GeoffroyLoiselet/Projet_2a_Drone_Amphibie/README.md

# Projet_2a_Drone_Amphibie
Projet drone amphibie ENSEA 2ème année
