GeoffroyLoiselet/Projet_2a_Drone_Amphibie/les étapes pour programmer le joystick.docx

Les étapes à suivre pour programmer le joystick :

SYS-→ Debug --→ Serial Wire

RCC -→ High speed clock (HSE) -→ Crystal ceramic resonator.

Analog → ADC1 Mode : – IN1→ Single Ended

-IN2 → Single Ended

Parameter Settings : Continuous Conversion Mode : Enable

Number of conversion : 2

Rank 1 → channel 1

Sampling time 640 cycles

Rank 2 -→ channel 2

Sampling time 640 cycles

DMA settings -→ add

Clique sur adc1puis choisis le mode circular

Data width : word dans les deux peripheral et memory

DMA Continuous Requests -→ Enabled

System view --→ NVIC -→ cochez ADC1 interrupt

Choisis un GPIO pour le bouton (exemple PA8) et mets le en GPIO-input

Allez au GPIO et mets le pin en Pull-up

Connectivity :

USART2 → Mode : Asynchronous

Génère le code Ctrl + S

Le code : (les parties importantes)

#include "main.h"

#include "stdio.h"

#include "string.h"

ADC_HandleTypeDef hadc1;

DMA_HandleTypeDef hdma_adc1;

UART_HandleTypeDef huart2;

uint16_t xValue;

uint16_t yValue;

uint32_t readValue [2];

uint8_t button_state;

char buffer[50];

void SystemClock_Config(void);

static void MX_GPIO_Init(void);

static void MX_DMA_Init(void);

static void MX_ADC1_Init(void);

static void MX_USART2_UART_Init(void);

int main(void)

{

HAL_Init();

SystemClock_Config();

MX_GPIO_Init();

MX_DMA_Init();

MX_ADC1_Init();

MX_USART2_UART_Init();

/* USER CODE BEGIN 2 */

HAL_ADC_Start_DMA(&hadc1, (uint32_t*)readValue, 2);

while (1)

{

/* USER CODE END WHILE */

for (uint8_t i =0 ;i<hadc1.Init.NbrOfConversion;i++){

xValue = (uint16_t ) readValue[0];

yValue = (uint16_t ) readValue[1];

}

button_state=HAL_GPIO_ReadPin(GPIOA, GPIO_PIN_8);

snprintf(buffer,sizeof(buffer),"Xvalue : %d, Yvalue : %d, Button : %d \r\n",xValue,yValue,button_state);

HAL_UART_Transmit(&huart2, (uint8_t *) buffer , sizeof(buffer), HAL_MAX_DELAY);

HAL_Delay(300);

/* USER CODE BEGIN 3 */

}

/* USER CODE END 3 */

}

Un video pour comprendre : https://youtu.be/rQGIqen2qxA
