GeoffroyLoiselet/Projet_2a_Drone_Amphibie/Manette/NRF24_protocole.txt

Warning pour l'utilisation du nrf24l01:

mettre un 1 a la 5e position du registre a laquelle tu veux adresser.
