GeoffroyLoiselet/Projet_2a_Drone_Amphibie/Drone/comprendre/Yaw_Axis_Corrected.svg.png

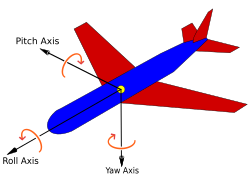
Drone/comprendre/Yaw_Axis_Corrected.svg.png
