GeoffroyLoiselet/Projet_2a_Drone_Amphibie/final.stp

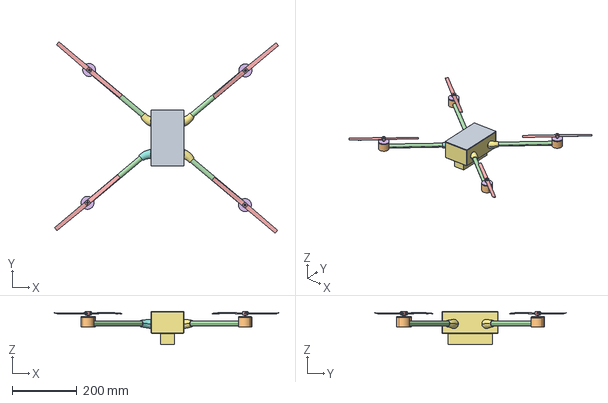
[picture p21: CAD file, 2025-11-04]
final.stp
689.7 x 589.5 x 103.0 mm
