GeoffroyLoiselet/Projet_2a_Drone_Amphibie/Model/Drone_projet v7.step

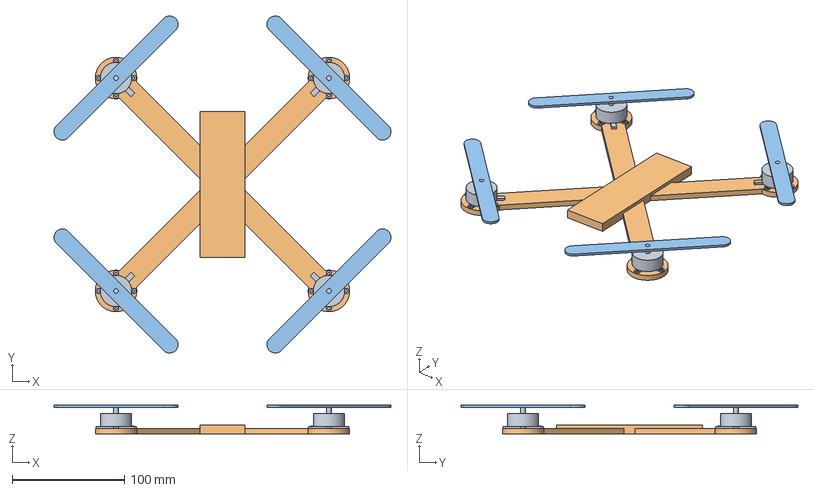
[picture p22: CAD file, 2025-10-07]
Model/Drone_projet v7.step
299.9 x 299.9 x 25.6 mm
moteur_projet x 4
Chassis_projet
Helice x 4
