GeoffroyLoiselet/Projet_2a_Drone_Amphibie/Model/Chassis_projet v4.step

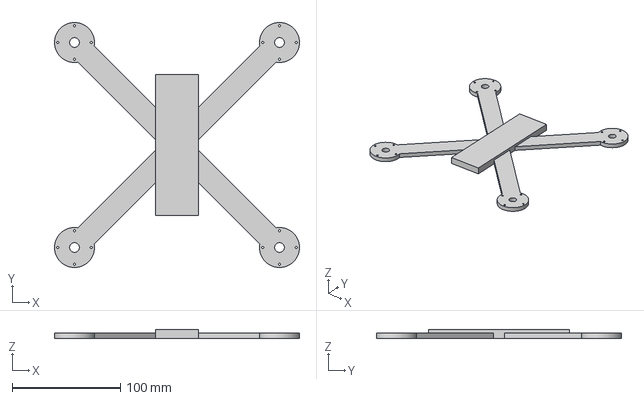
[picture p23: CAD file, 2025-10-07]
Model/Chassis_projet v4.step
226.5 x 226.5 x 8.00 mm
