GeoffroyLoiselet/Projet_2a_Drone_Amphibie/Model/Helice v5.step

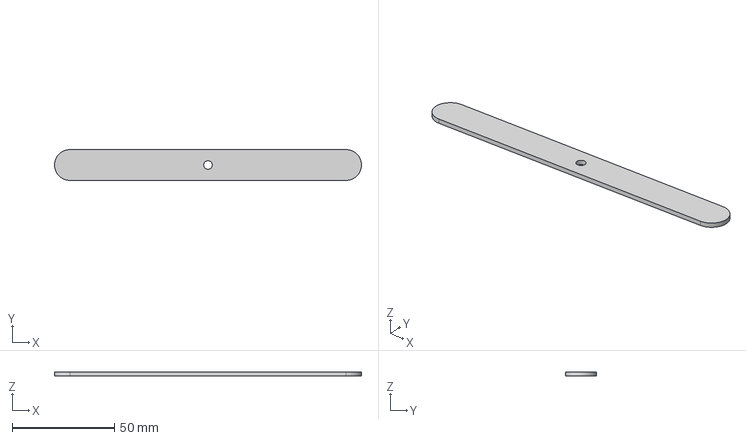
[picture p24: CAD file, 2025-10-07]
Model/Helice v5.step
150.0 x 15.0 x 2.00 mm
