GeoffroyLoiselet/Projet_2a_Drone_Amphibie/Model/moteur_projet v5.step

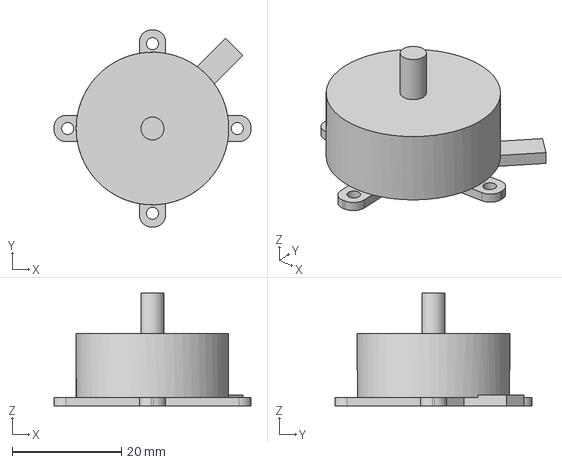
[picture p25: CAD file, 2025-10-07]
Model/moteur_projet v5.step
36.0 x 36.0 x 20.6 mm
