GeoffroyLoiselet/Projet_2a_Drone_Amphibie/Drone/PCB/V2/Puissance/Puissance.kicad_pcb

## KiCad design Drone/PCB/V2/Puissance/Puissance.kicad_pcb (2026-02-17)

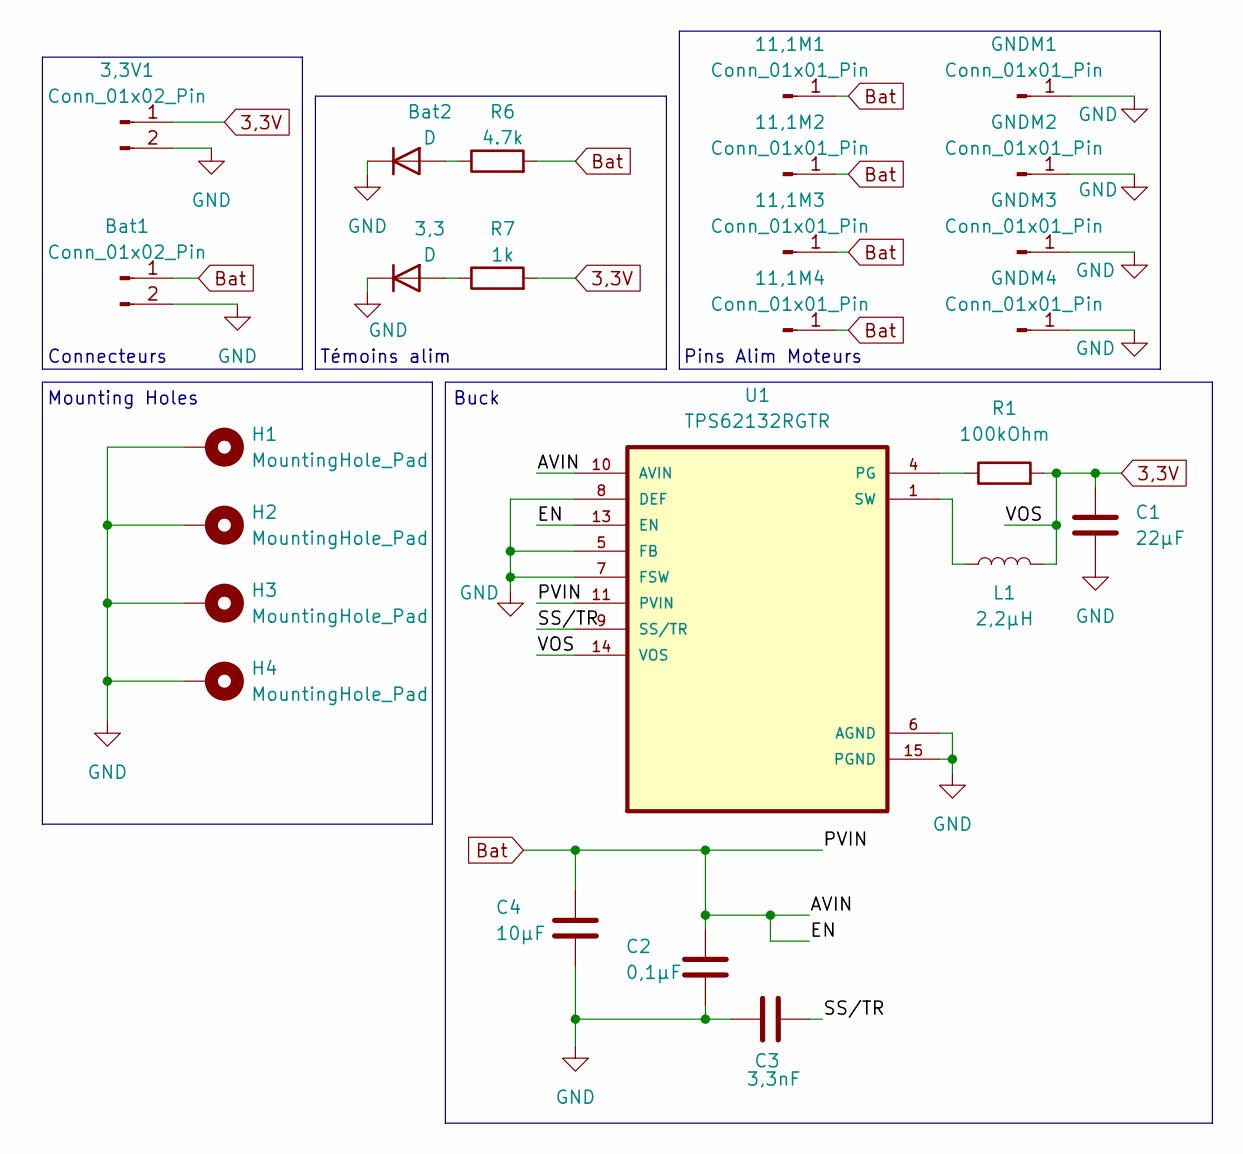
[picture p26: schematic Puissance.kicad_sch]

Parts:
3,3: D; D_0603_1608Metric_Pad1.05x0.95mm_HandSolder
3,3V1: Conn_01x02_Pin; PinSocket_1x02_P2.54mm_Vertical
11,1M1, 11,1M2, 11,1M3, 11,1M4: Conn_01x01_Pin; SolderWire-1.5sqmm_1x01_D1.7mm_OD3mm
Bat1: Conn_01x02_Pin; SolderWire-1.5sqmm_1x02_P6mm_D1.7mm_OD3mm
Bat2: D; D_0603_1608Metric_Pad1.05x0.95mm_HandSolder
C1: 22µF; C_0603_1608Metric_Pad1.08x0.95mm_HandSolder
C2: 0,1µF; C_0603_1608Metric_Pad1.08x0.95mm_HandSolder
C3: 3,3nF; C_0603_1608Metric_Pad1.08x0.95mm_HandSolder
C4: 10µF; C_0603_1608Metric_Pad1.08x0.95mm_HandSolder
GNDM1, GNDM2, GNDM3, GNDM4: Conn_01x01_Pin; SolderWire-1.5sqmm_1x01_D1.7mm_OD3mm
H1, H2, H3, H4: MountingHole_Pad; MountingHole_3.2mm_M3_DIN965_Pad
L1: 2,2µH; L_0603_1608Metric_Pad1.05x0.95mm_HandSolder
R1: 100kOhm; R_0201_0603Metric_Pad0.64x0.40mm_HandSolder
R6: 4.7k; R_0603_1608Metric_Pad0.98x0.95mm_HandSolder
R7: 1k; R_0603_1608Metric_Pad0.98x0.95mm_HandSolder
U1: TPS62132RGTR; VQFN-16-1EP_3x3mm_P0.5mm_EP1.1x1.1mm_ThermalVias

Connections:
3,3V: 3,3V1.1, C1.1, L1.2, R1.2, R7.2, U1.14 (VOS)
/SS/TR: C3.2, U1.9 (SS/TR)
Bat: 11,1M1.1, 11,1M2.1, 11,1M3.1, 11,1M4.1, Bat1.1, C2.1, C4.1, R6.2, U1.10 (AVIN), U1.11 (PVIN), U1.12 (PVIN), U1.13 (EN)
GND: 3,3.1 (K), 3,3V1.2, Bat1.2, Bat2.1 (K), C1.2, C2.2, C3.1, C4.2, GNDM1.1, GNDM2.1, GNDM3.1, GNDM4.1, H1.1, H2.1, H3.1, H4.1, U1.5 (FB), U1.6 (AGND), U1.7 (FSW), U1.8 (DEF), U1.15 (PGND), U1.16 (PGND), U1.17 (PGND)
unnamed: 3,3.2 (A), R7.1
unnamed: Bat2.2 (A), R6.1
unnamed: L1.1, U1.1 (SW), U1.2 (SW), U1.3 (SW)
unnamed: R1.1, U1.4 (PG)

Notes on the sheet:
Pins Alim Moteurs
Connecteurs
Buck
Mounting Holes
Témoins alim

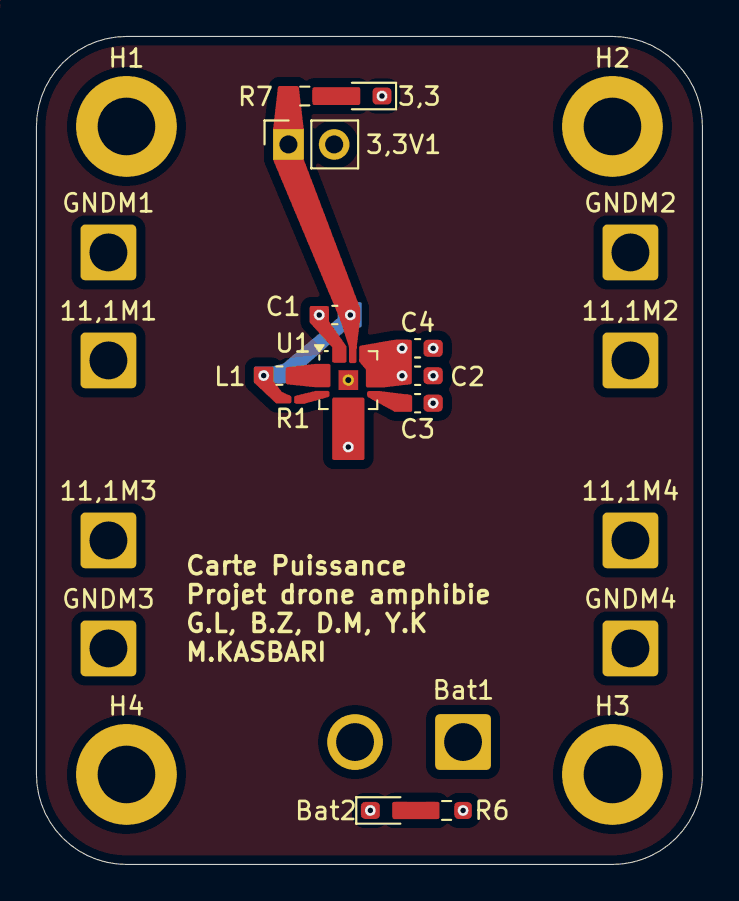
[picture p27: board Drone/PCB/V2/Puissance/Puissance.kicad_pcb from above]

Board: 4 copper layers, 37.0 x 46.0 mm, 25 parts (0 on the bottom side), 8 nets.
