GeoffroyLoiselet/Projet_2a_Drone_Amphibie/Drone/PCB/V2/Drone/Drone.kicad_pcb

## KiCad design Drone/PCB/V2/Drone/Drone.kicad_pcb (2026-02-17)

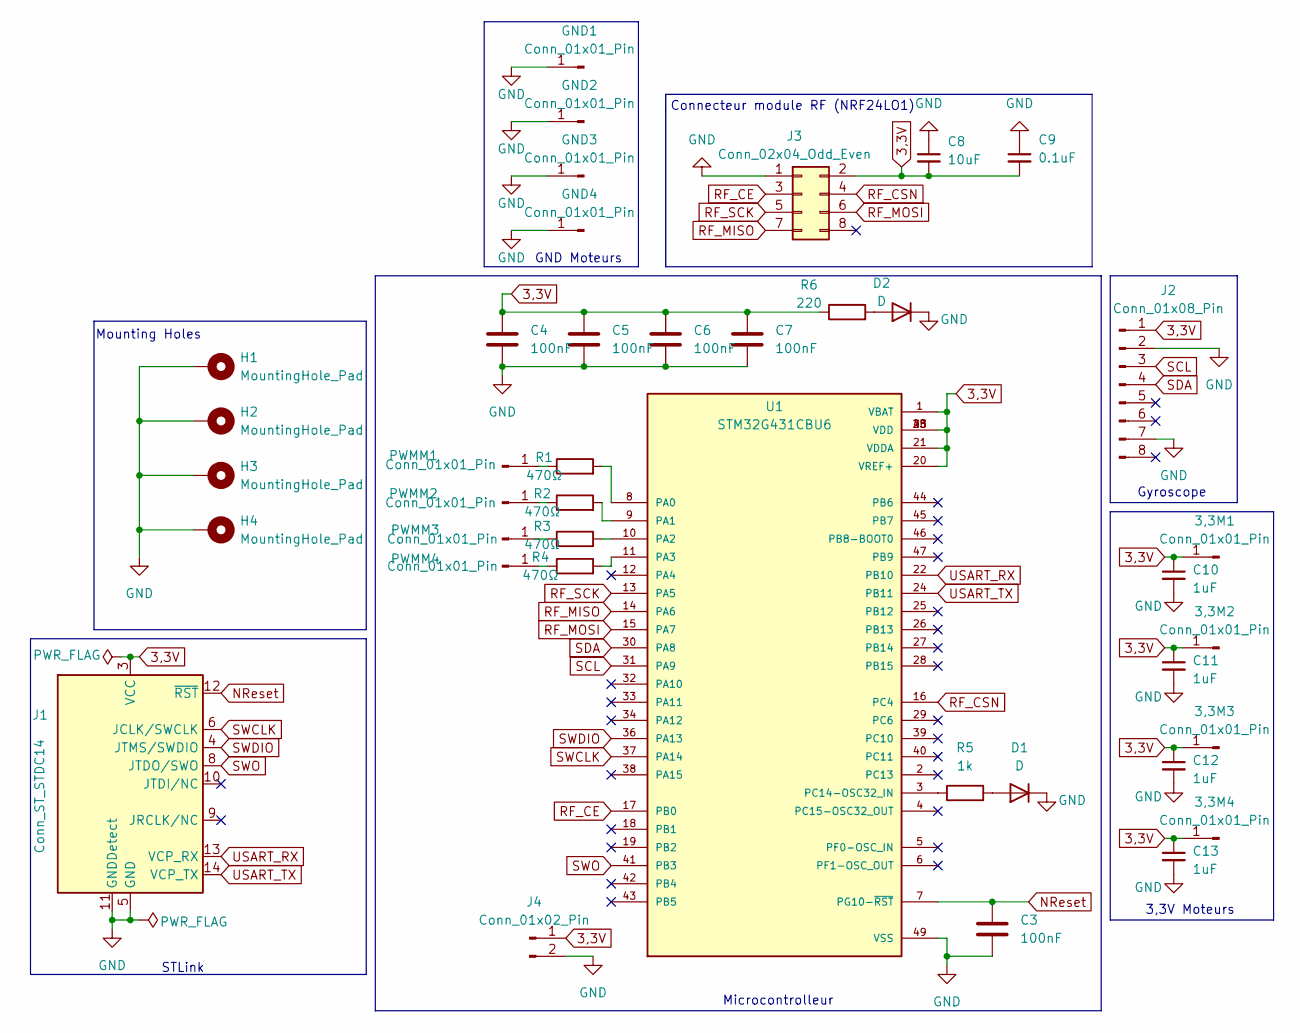
[picture p28: schematic Drone.kicad_sch, PCB_Drone]

Parts:
3,3M1, 3,3M2, 3,3M3, 3,3M4: Conn_01x01_Pin; SolderWire-0.75sqmm_1x01_D1.25mm_OD2.3mm
C3, C4, C5, C6, C7: 100nF; C_0603_1608Metric_Pad1.08x0.95mm_HandSolder
C8: 10uF; C_0603_1608Metric_Pad1.08x0.95mm_HandSolder
C9: 0.1uF; C_0603_1608Metric_Pad1.08x0.95mm_HandSolder
C10, C11, C12, C13: 1uF; C_0603_1608Metric_Pad1.08x0.95mm_HandSolder
D1, D2: D; D_0603_1608Metric_Pad1.05x0.95mm_HandSolder
GND1, GND2, GND3, GND4: Conn_01x01_Pin; SolderWire-0.75sqmm_1x01_D1.25mm_OD2.3mm
H1, H2, H3, H4: MountingHole_Pad; MountingHole_3.2mm_M3_DIN965_Pad
J1: Conn_ST_STDC14; PinHeader_2x07_P1.27mm_Vertical_SMD
J2: Conn_01x08_Pin; PinSocket_1x08_P1.00mm_Vertical
J3: Conn_02x04_Odd_Even; JST_PHD_B8B-PHDSS_2x04_P2.00mm_Vertical
J4: Conn_01x02_Pin; PinSocket_1x02_P2.54mm_Vertical
PWMM1, PWMM2, PWMM3, PWMM4: Conn_01x01_Pin; SolderWire-0.75sqmm_1x01_D1.25mm_OD2.3mm
R1, R2, R3, R4: 470Ω; R_0603_1608Metric_Pad0.98x0.95mm_HandSolder
R5: 1k; R_0603_1608Metric_Pad0.98x0.95mm_HandSolder
R6: 220; R_0603_1608Metric_Pad0.98x0.95mm_HandSolder
U1: STM32G431CBU6; QFN50P700X700X60-49N; PARTREV 6

Connections:
3,3V: 3,3M1.1, 3,3M2.1, 3,3M3.1, 3,3M4.1, C4.1, C5.1, C6.1, C7.1, C8.2, C9.2, C10.1, C11.1, C12.1, C13.1, J1.3 (VCC), J2.1, J3.2, J4.1, R6.1, U1.1 (VBAT), U1.20 (VREF+), U1.21 (VDDA), U1.23 (VDD), U1.35 (VDD), U1.48 (VDD)
GND: C3.2, C4.2, C5.2, C6.2, C7.2, C8.1, C9.1, C10.2, C11.2, C12.2, C13.2, D1.1 (K), D2.1 (K), GND1.1, GND2.1, GND3.1, GND4.1, H1.1, H2.1, H3.1, H4.1, J1.5 (GND), J1.7 (GND), J1.11 (GNDDetect), J2.2, J2.7, J3.1, J4.2, U1.49 (VSS)
NReset: C3.1, J1.12 (~RST), U1.7 (PG10-~RST)
unnamed: D1.2 (A), R5.2
unnamed: D2.2 (A), R6.2
unnamed: PWMM1.1, R1.1
unnamed: PWMM2.1, R2.1
unnamed: PWMM3.1, R3.1
unnamed: PWMM4.1, R4.1
unnamed: R1.2, U1.8 (PA0)
unnamed: R2.2, U1.9 (PA1)
unnamed: R3.2, U1.10 (PA2)
unnamed: R4.2, U1.11 (PA3)
unnamed: R5.1, U1.3 (PC14-OSC32_IN)
RF_CE: J3.3, U1.17 (PB0)
RF_CSN: J3.4, U1.16 (PC4)
RF_MISO: J3.7, U1.14 (PA6)
RF_MOSI: J3.6, U1.15 (PA7)
RF_SCK: J3.5, U1.13 (PA5)
SCL: J2.3, U1.31 (PA9)
SDA: J2.4, U1.30 (PA8)
SWCLK: J1.6 (JCLK/SWCLK), U1.37 (PA14)
SWDIO: J1.4 (JTMS/SWDIO), U1.36 (PA13)
SWO: J1.8 (JTDO/SWO), U1.41 (PB3)
USART_RX: J1.13 (VCP_RX), U1.22 (PB10)
USART_TX: J1.14 (VCP_TX), U1.24 (PB11)

Notes on the sheet:
3,3V Moteurs
Connecteur module RF (NRF24LO1)
Microcontrolleur
Gyroscope
STLink
Mounting Holes
GND Moteurs

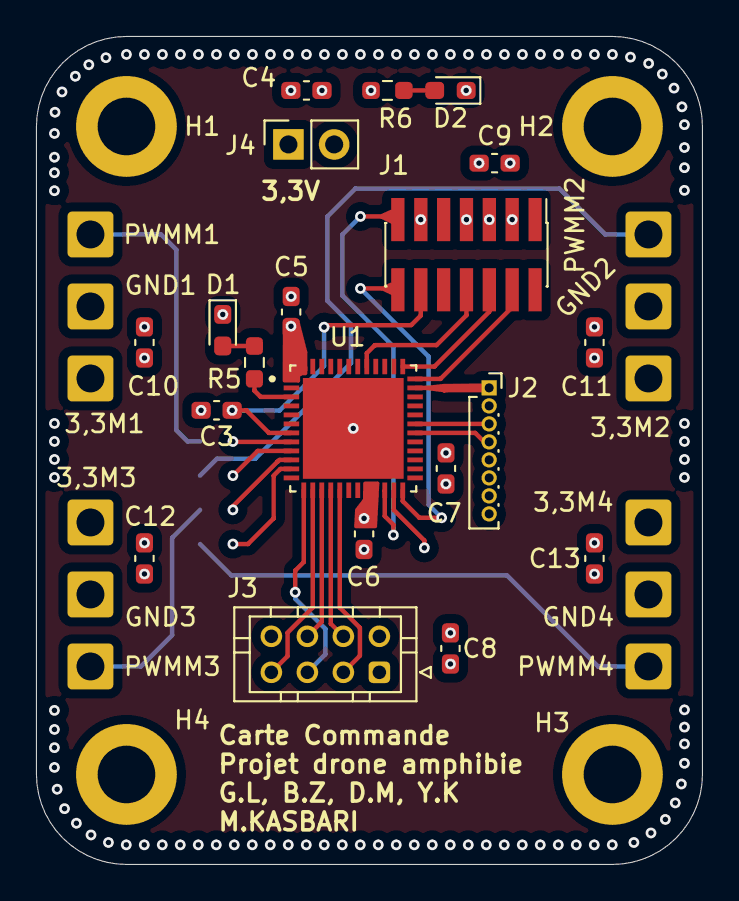
[picture p29: board Drone.kicad_pcb from above]

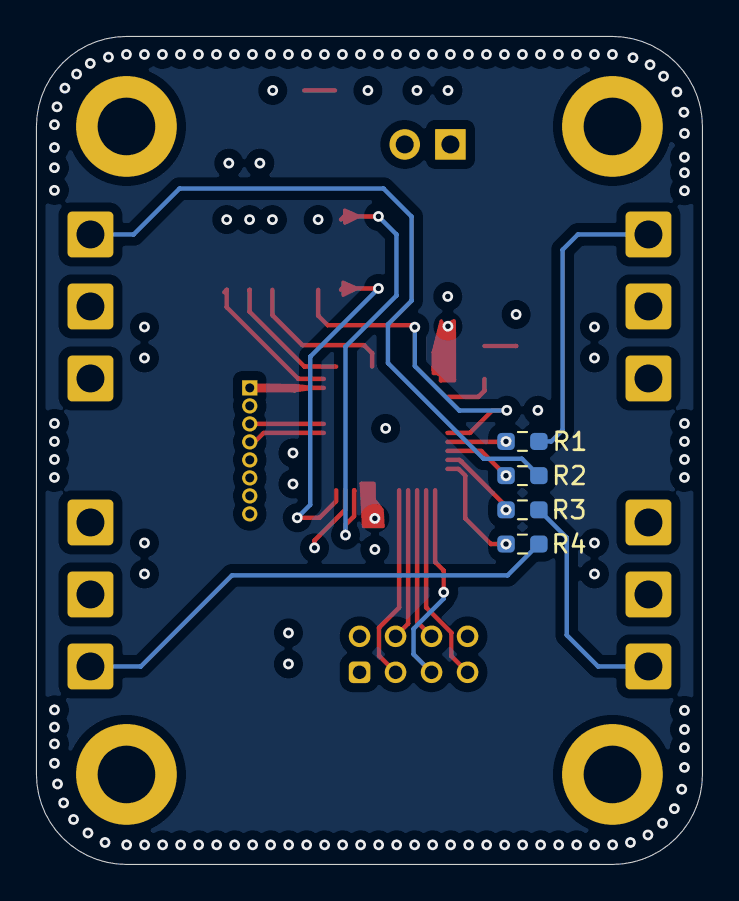
[picture p30: board Drone.kicad_pcb from below]

Board: 4 copper layers, 37.0 x 46.0 mm, 40 parts (4 on the bottom side), 26 nets.
