GeoffroyLoiselet/Projet_2a_Drone_Amphibie/Drone/PCB/Carte_Puissance/Puissance.kicad_pcb

## KiCad design Drone/PCB/Carte_Puissance/Puissance.kicad_pcb (2026-01-14, an earlier design)

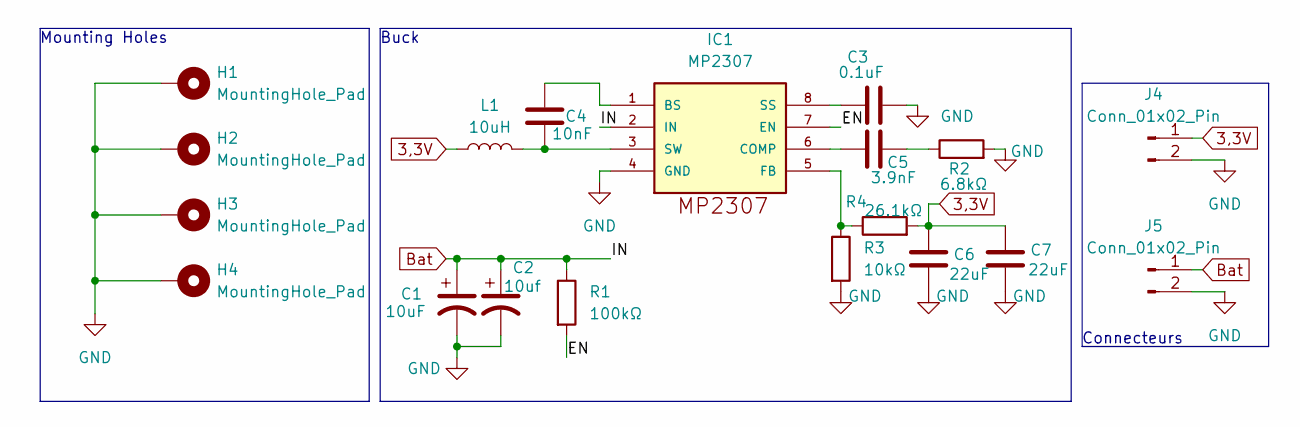
[picture p31: schematic Puissance.kicad_sch]

Parts:
C1: 10uF; C_0603_1608Metric_Pad1.08x0.95mm_HandSolder
C2: 10uf; C_0603_1608Metric_Pad1.08x0.95mm_HandSolder
C3: 0.1uF; C_0603_1608Metric_Pad1.08x0.95mm_HandSolder
C4: 10nF; C_0603_1608Metric_Pad1.08x0.95mm_HandSolder
C5: 3.9nF; C_0603_1608Metric_Pad1.08x0.95mm_HandSolder
C6, C7: 22uF; C_0603_1608Metric_Pad1.08x0.95mm_HandSolder
H1, H2, H3, H4: MountingHole_Pad; MountingHole_3.2mm_M3_DIN965_Pad
IC1: MP2307; MP2307DN
J4, J5: Conn_01x02_Pin; PinSocket_1x02_P2.54mm_Vertical
L1: 10uH; L_0603_1608Metric_Pad1.05x0.95mm_HandSolder
R1: 100kΩ; R_0603_1608Metric_Pad0.98x0.95mm_HandSolder
R2: 6.8kΩ; R_0603_1608Metric_Pad0.98x0.95mm_HandSolder
R3: 10kΩ; R_0603_1608Metric_Pad0.98x0.95mm_HandSolder
R4: 26.1kΩ; R_0603_1608Metric_Pad0.98x0.95mm_HandSolder

Connections:
3,3V: C6.1, C7.1, J4.1, L1.1, R4.2
/EN: IC1.7 (EN), R1.2
Bat: C1.1, C2.1, IC1.2 (IN), J5.1, R1.1
GND: C1.2, C2.2, C3.2, C6.2, C7.2, H1.1, H2.1, H3.1, H4.1, IC1.4 (GND), IC1.9, J4.2, J5.2, R2.2, R3.2
unnamed: C5.2, R2.1
unnamed: C4.2, IC1.1 (BS)
unnamed: C5.1, IC1.6 (COMP)
unnamed: IC1.5 (FB), R3.1, R4.1
unnamed: C3.1, IC1.8 (SS)
unnamed: C4.1, IC1.3 (SW), L1.2

Notes on the sheet:
Connecteurs
Buck
Mounting Holes

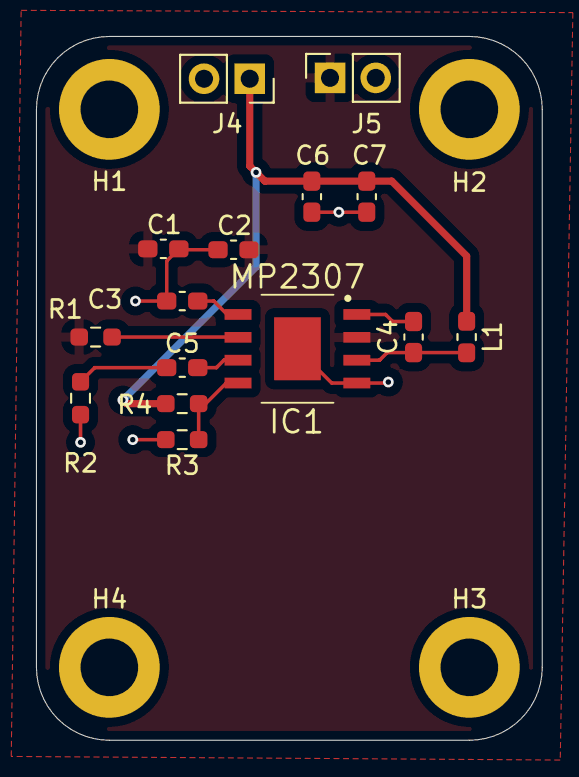
[picture p32: board Drone/PCB/Carte_Puissance/Puissance.kicad_pcb from above]

Board: 2 copper layers, 28.1 x 39.1 mm, 19 parts (0 on the bottom side), 10 nets.
