GeoffroyLoiselet/Projet_2a_Drone_Amphibie/Manette/PCB/Drone_Controller.kicad_pcb

## KiCad design Manette/PCB/Drone_Controller.kicad_pcb (2025-10-26)

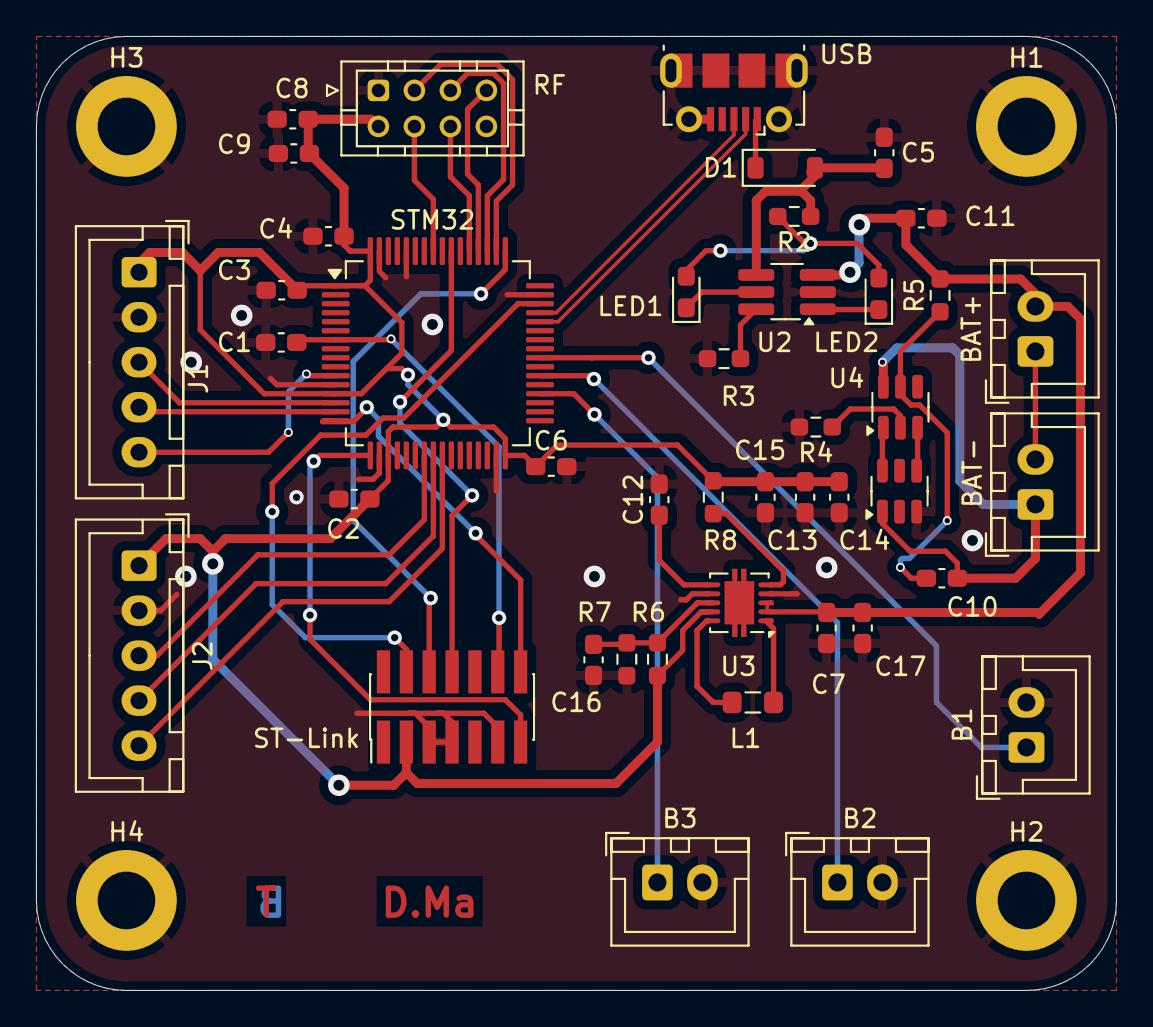
[picture p33: board Drone_Controller.kicad_pcb from above]

Board: 2 copper layers, 60.0 x 53.0 mm, 47 parts (0 on the bottom side), 42 nets.

Parts:
B1, B2, B3: Conn_01x02_Socket; JST_XH_B2B-XH-A_1x02_P2.50mm_Vertical
BAT+: Conn_01x02_Socket; JST_XH_B2B-XH-A_1x02_P2.50mm_Vertical
BAT-: Conn_01x02_Socket; JST_XH_B2B-XH-A_1x02_P2.50mm_Vertical
C1, C2, C3, C4, C6: 100nF; C_0603_1608Metric_Pad1.08x0.95mm_HandSolder
C5: 2.2uF; C_0603_1608Metric_Pad1.08x0.95mm_HandSolder
C7, C8, C17: 10uF; C_0603_1608Metric_Pad1.08x0.95mm_HandSolder
C9, C10, C12: 0.1uF; C_0603_1608Metric_Pad1.08x0.95mm_HandSolder
C11: C_Small; C_0603_1608Metric_Pad1.08x0.95mm_HandSolder
C13, C14, C15: 22uF; C_0603_1608Metric_Pad1.08x0.95mm_HandSolder
C16: 10pF; C_0603_1608Metric_Pad1.08x0.95mm_HandSolder
D1: D_Small; D_SOD-123
H1, H2, H3, H4: MountingHole_Pad; MountingHole_3.2mm_M3_DIN965_Pad
J1, J2: Conn_01x05_Pin; JST_XH_B5B-XH-A_1x05_P2.50mm_Vertical
L1: 1uH; L_0805_2012Metric_Pad1.05x1.20mm_HandSolder
LED1, LED2: LED_Small; LED_0603_1608Metric_Pad1.05x0.95mm_HandSolder
R2: 330; R_0603_1608Metric_Pad0.98x0.95mm_HandSolder
R3: R_PRG; R_0603_1608Metric_Pad0.98x0.95mm_HandSolder
R4, R6, R7: R_Small; R_0603_1608Metric_Pad0.98x0.95mm_HandSolder
R5: 100; R_0603_1608Metric_Pad0.98x0.95mm_HandSolder
R8: 1M; R_0603_1608Metric_Pad0.98x0.95mm_HandSolder
RF: Conn_02x04_Odd_Even; JST_PHD_B8B-PHDSS_2x04_P2.00mm_Vertical
ST-Link: Conn_ST_STDC14; PinHeader_2x07_P1.27mm_Vertical_SMD
STM32: STM32L476RGTx; LQFP-64_10x10mm_P0.5mm
U2: TP4057; TSOT-23-6_HandSoldering
U3: TPS63060DSCR; Texas_DSC0010J
U4: DW01A; SOT-23-6
U5: 8205A; SOT-23-6
USB: USB_B_Micro; USB_Micro-B_Molex-105017-0001

Connections:
+3.3V: C2.1, C3.1, C4.1, C6.1, C8.2, C9.2, C13.1, C14.1, C15.1, J1.1, J2.1, R6.1, R8.2, RF.2, ST-Link.3 (VCC), STM32.1 (VBAT), STM32.13 (VDDA), STM32.19 (VDD), STM32.32 (VDD), STM32.64 (VDD), U3.9 (VOUT)
+5V: C5.2, D1.2 (A), R2.1, U2.4 (VCC)
BAT+: BAT+.2, C7.1, C11.2, C17.1, R5.2, U2.3 (BAT), U3.2 (VIN), U3.3 (EN)
BAT-: BAT-.1, C10.2, U4.6 (GND), U5.1
Button1: B1.1, STM32.40 (PC9)
Button2: B2.1, STM32.38 (PC7)
Button3: B3.1, STM32.36 (PB15)
FB: C16.1, R6.2, R7.1, U3.8 (FB)
GND: B1.2, B2.2, B3.2, C1.2, C2.2, C3.2, C4.2, C5.1, C6.2, C7.2, C8.1, C9.1, C11.1, C12.2, C13.2, C14.2, C15.2, C16.2, C17.2, H1.1, H2.1, H3.1, H4.1, J1.2, J2.2, R3.1, R4.2, R7.2, RF.1, ST-Link.5 (GND), ST-Link.7 (GND), ST-Link.11 (GNDDetect), STM32.12 (VSSA), STM32.18 (VSS), STM32.31 (VSS), STM32.47 (VSS), STM32.60 (BOOT0), STM32.63 (VSS), U2.2 (GND), U3.4 (PS/SYNC), U3.7 (GND), U5.3, USB.5 (GND), USB.6 (Shield)
Joystick1_switch: J1.5, STM32.11 (PC3)
Joystick1_x: J1.3, STM32.14 (PA0)
Joystick1_y: J1.4, STM32.15 (PA1)
Joystick2_switch: J2.5, STM32.25 (PC5)
Joystick2_x: J2.3, STM32.23 (PA7)
Joystick2_y: J2.4, STM32.24 (PC4)
NRST: C1.1, ST-Link.12 (~RST), STM32.7 (NRST)
unnamed: D1.1 (K), USB.1 (VBUS)
unnamed: LED1.2 (A), LED2.2 (A), R2.2
unnamed: LED2.1 (K), U2.1 (~CHRG)
unnamed: LED1.1 (K), U2.5 (~STDBY)
unnamed: BAT+.1, BAT-.2
unnamed: R3.2, U2.6 (PROG)
unnamed: L1.2, U3.1 (L1)
unnamed: L1.1, U3.10 (L2)
unnamed: R8.1, U3.5 (PG)
unnamed: C12.1, U3.6 (VAUX)
unnamed: R4.1, U4.2 (CS)
unnamed: U4.3 (OC), U5.4
unnamed: U4.1 (OD), U5.6
unnamed: C10.1, R5.1, U4.5 (VCC)
RF_CE: RF.3, STM32.50 (PA15)
RF_CSN: RF.4, STM32.57 (PB5)
RF_MISO: RF.7, STM32.52 (PC11)
RF_MOSI: RF.6, STM32.53 (PC12)
RF_SCK: RF.5, STM32.51 (PC10)
SWCLK: ST-Link.6 (JCLK/SWCLK), STM32.49 (PA14)
SWDIO: ST-Link.4 (JTMS/SWDIO), STM32.46 (PA13)
SWO: ST-Link.8 (JTDO/SWO), STM32.55 (PB3)
USART_RX: ST-Link.13 (VCP_RX), STM32.17 (PA3)
USART_TX: ST-Link.14 (VCP_TX), STM32.16 (PA2)
USB_D+: STM32.45 (PA12), USB.3 (D+)
USB_D-: STM32.44 (PA11), USB.2 (D-)
