GeoffroyLoiselet/Projet_2a_Drone_Amphibie/(commit log)

2025-09-30 Programme pour STM32 fonctionnement moteur
2025-10-07 Create Code qui affiche gyro+accelerometre
2025-11-18 Create PCB
2025-11-18 Rename Moteur BLDC and propellers.docx to Drone/Datasheet/Moteur BLDC and propellers.docx
2025-12-19 Add motor usage instructions to Utilisation.txt
    Added usage instructions for the motor including power supply and PWM settings.
2026-02-17 nouveau main.c pour le nrf24 RX
    permet de lire le message envoyé (+ affichage led) mode privilégié de lecture = puTTY en serial com5
